ZakSN/m2cpu/software/README

This directory contains software written for the m2cpu. 
The m2cpu assembler is in tools/assembler
