ZakSN/m2cpu/software/hello_world/README

prints "Hello, world!" followed by a blinking cursor, in the middle of the screen
