ZakSN/m2cpu/doc/processor/M2CPU_architecture_diagram.png

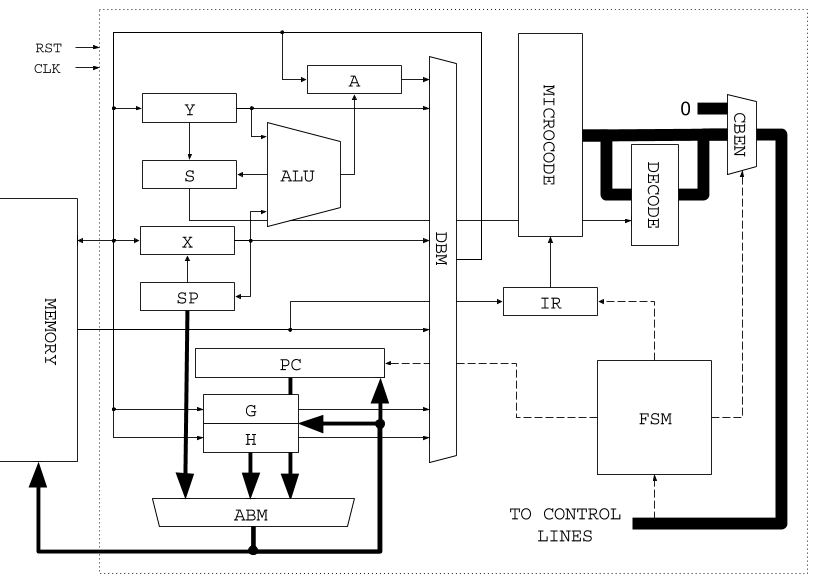
doc/processor/M2CPU_architecture_diagram.png
