ZakSN/m2cpu/doc/processor/M2CPU_FSM.png

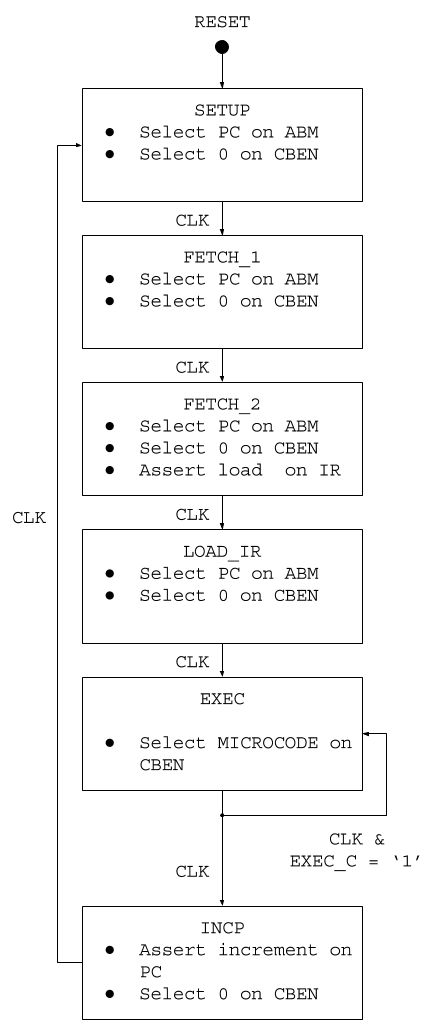
doc/processor/M2CPU_FSM.png
