ZakSN/m2cpu/video/byte_to_text.vhd

library ieee;
use ieee.std_logic_1164.all;
use ieee.numeric_std.all;

entity byte_to_text is port
(
	byte_in : in std_logic_vector(7 downto 0);
	line_out : out std_logic_vector(9 downto 0);
	line_sel : in std_logic_vector(4 downto 0)
);
end entity byte_to_text;

architecture a0 of byte_to_text is
	constant non_printing : integer := 32;
	constant char_set_size : integer := 112;
	signal lo : std_logic_vector(9 downto 0);
	type font_rom_array is array (0 to (char_set_size * 25) - 1) of std_logic_vector(9 downto 0);
	signal font_rom : font_rom_array;
	signal byte_num : integer;
	signal line_num : integer;
	signal c_t_p : integer;
	signal char_to_print : integer;

begin

	byte_num <= to_integer(unsigned(byte_in));
	line_num <= to_integer(unsigned(line_sel));
	-- assuming that all chars we recieve print as either a space or map to a printing char
	-- non printing chars (zero-width) need to be filtered out earlier. 
	-- by the time we get here we have to print something
	-- the next line ensures we print something predictable
	char_to_print <= (byte_num - non_printing) when (byte_num >= non_printing) AND (byte_num < (char_set_size + non_printing - 1)) else 0;
	line_out <= font_rom((char_to_print * 25) + line_num);
	
-- prototype char:
-- top five lines and bottom five lines are blanked for
-- text seperation
-- texh chars have a one pixel buffer on each edge (look at examples below)
--	"0000000000",
--	"0000000000",
--	"0000000000",
--	"0000000000",
--	"0000000000",
--	
--	"0000000000",
--	"0000000000",
--	"0000000000",
--	"0000000000",
--	"0000000000",
--	"0000000000",
--	"0000000000",
--	"0000000000",
--	"0000000000",
--	"0000000000",
--	"0000000000",
--	"0000000000",
--	"0000000000",
--	"0000000000",
--	"0000000000",
--	
--	"0000000000",
--	"0000000000",
--	"0000000000",
--	"0000000000",
--	"0000000000",


-- literal miles of font rom:
-- char are surrounded by "--{X" and "--X}"
-- where X is the particular char

	font_rom <=(
		--{SPACE
		"0000000000",
		"0000000000",
		"0000000000",
		"0000000000",
		"0000000000",
		"0000000000",
		"0000000000",
		"0000000000",
		"0000000000",
		"0000000000",
		"0000000000",
		"0000000000",
		"0000000000",
		"0000000000",
		"0000000000",
		"0000000000",
		"0000000000",
		"0000000000",
		"0000000000",
		"0000000000",
		"0000000000",
		"0000000000",
		"0000000000",
		"0000000000",
		"0000000000",
		--SPACE}
		--{!
		"0000000000",
		"0000000000",
		"0000000000",
		"0000000000",
		"0000000000",
		"0000110000",
		"0000110000",
		"0000110000",
		"0000110000",
		"0000110000",
		"0000110000",
		"0000110000",
		"0000110000",
		"0000110000",
		"0000110000",
		"0000110000",
		"0000000000",
		"0000000000",
		"0000110000",
		"0000110000",
		"0000000000",
		"0000000000",
		"0000000000",
		"0000000000",
		"0000000000",
		--!}
		--{"
		"0000000000",
		"0000000000",
		"0000000000",
		"0000000000",
		"0000000000",
		"0111001110",
		"0111001110",
		"0110001100",
		"0110001100",
		"0000000000",
		"0000000000",
		"0000000000",
		"0000000000",
		"0000000000",
		"0000000000",
		"0000000000",
		"0000000000",
		"0000000000",
		"0000000000",
		"0000000000",
		"0000000000",
		"0000000000",
		"0000000000",
		"0000000000",
		"0000000000",
		--"}
		--{#
		"0000000000",
		"0000000000",
		"0000000000",
		"0000000000",
		"0000000000",
		"0011001100",
		"0011001100",
		"0011001100",
		"0011001100",
		"0111111110",
		"0111111110",
		"0011001100",
		"0011001100",
		"0011001100",
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
		"0101010101",
		"1010101010",
		"0101010101",
		"1010101010",
		"0101010101",
		"1010101010",
		"0101010101",
		"1010101010",
		"0101010101",
		"1010101010",
		"0101010101",
		"1010101010",
		"0101010101",
		"1010101010",
		"0101010101",
		"1010101010",
		"0101010101",
		"1010101010",
		"0101010101",
		"1010101010",
		"0101010101",
		"1010101010",
		--}
		--{ full block (141)
		"1111111111",
		"1111111111",
		"1111111111",
		"1111111111",
		"1111111111",
		"1111111111",
		"1111111111",
		"1111111111",
		"1111111111",
		"1111111111",
		"1111111111",
		"1111111111",
		"1111111111",
		"1111111111",
		"1111111111",
		"1111111111",
		"1111111111",
		"1111111111",
		"1111111111",
		"1111111111",
		"1111111111",
		"1111111111",
		"1111111111",
		"1111111111",
		"1111111111",
		--}
		--{ cursor (142)
		"0000000000",
		"0000000000",
		"0000000000",
		"0000000000",
		"0000000000",
		"1111111111",
		"1111111111",
		"1111111111",
		"1111111111",
		"1111111111",
		"1111111111",
		"1111111111",
		"1111111111",
		"1111111111",
		"1111111111",
		"1111111111",
		"1111111111",
		"1111111111",
		"1111111111",
		"1111111111",
		"0000000000",
		"0000000000",
		"0000000000",
		"0000000000",
		"0000000000",
		--}
		others => "0000000000"
	);

end architecture a0;
