ZakSN/m2cpu/processor/microcode_LUT.vhd

library ieee;
use ieee.std_logic_1164.all;

entity microcode_LUT is port
(
	address : in std_logic_vector(7 downto 0);
	microinstruction : out std_logic_vector(41 downto 0)
);
end entity microcode_LUT;

architecture a0 of microcode_LUT is
begin

	with address select
		microinstruction <= "000000000000000000000000000000000000000000" when "00000000",
									"100000000000000000000000000000000000100001" when "00000001",
									"000000000000000000000000000000000000000001" when "00000010",
									"100000000000000000000000000000000000100010" when "00000011",
									"000000000000000000000000000000000000000010" when "00000100",
									"100000000000000000000000000000000000100011" when "00000101",
									"000000000000000000000000000000000000000011" when "00000110",
									"100000000000000000000000000000000000100100" when "00000111",
									"000000000000000000000000000000000000000100" when "00001000",
									"100000000000000000000000000000000010000000" when "00010001",
									"000000000000000000000000000000000000000000" when "00010010",
									"100000000000000000000000000000000010000010" when "00010011",
									"000000000000000000000000000000000000000010" when "00010100",
									"100000000000000000000000000000000010000011" when "00010101",
									"000000000000000000000000000000000000000011" when "00010110",
									"100000000000000000000000000000000010000100" when "00010111",
									"000000000000000000000000000000000000000100" when "00011000",
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
									"000001000000000000000000000000000000000000" when "01011110",
									"000000001000000000000000000000000000000000" when "01101110",
									"000000010000000000000000000000000000000000" when "01111110",
									(0 => '0', others => '0') when others;
end architecture a0;
