ZakSN/m2cpu/video/vertical_signal.vhd

library ieee;
use ieee.std_logic_1164.all;
use ieee.numeric_std.all;

entity vertical_signal is
generic
(
	-- constants for vertical resolution
	-- units of lines
	front_porch : integer;
	sync_pulse : integer;
	back_porch : integer;
	active_video : integer;
	-- polarity of sync pulse
	sync_pulse_pol : std_logic;
	-- constant for line length
	-- unit of pixels
	pixel_per_line : integer
); 
port
(
	vsync_out : out std_logic; -- vertical sync
	len_out : out std_logic; -- line enable
	clk : in std_logic; -- pixel clock in
	rs : in std_logic -- async reset
);
end entity vertical_signal;

architecture a0 of vertical_signal is

	constant line_number : integer := (front_porch + sync_pulse + back_porch + active_video) * pixel_per_line;
	constant fpsp : integer := (front_porch + sync_pulse) * pixel_per_line;
	constant fpspbp : integer := (front_porch + sync_pulse + back_porch) * pixel_per_line;
	signal line_counter : integer := 0;
	signal len : std_logic;
	signal vsync : std_logic;

begin
	
	vsync_out <= vsync;
	len_out <= len;
	
	vs : process (clk, rs)
	begin
		if (rs = '1') then
			len <= '0';
			vsync <= '0';
			line_counter <= 0;
		elsif (rising_edge(clk)) then
			
			if (line_counter = line_number - 1) then
				line_counter <= 0;
			else
				line_counter <= line_counter + 1;
			end if;
			
			if (line_counter < (front_porch * pixel_per_line)) then
				len <= '0';
				vsync <= NOT(sync_pulse_pol);
			elsif ((line_counter >= (front_porch * pixel_per_line)) AND (line_counter < fpsp)) then
				len <= '0';
				vsync <= sync_pulse_pol;
			elsif ((line_counter >= fpsp) AND (line_counter < fpspbp)) then
				len <= '0';
				vsync <= NOT(sync_pulse_pol);
			else
				len <= '1';
				vsync <= NOT(sync_pulse_pol); 
			end if;
			
		else 
			len <= len;
			vsync <= vsync;
			line_counter <= line_counter;
		end if;
	end process vs;

end architecture a0;
