ZakSN/m2cpu/tools/assembler/cmd_line.h

#include <string>

#ifndef _CMD_LINE_H
#define _CMD_LINE_H
struct cmd{
	bool verbose;
	std::string infile;
	std::string outfile;
	int base_addr;
	bool give_up;
};

cmd parse_cmd (int argc, char** argv);
void usage_error();
#endif
