ZakSN/m2cpu/(commit log)

2017-10-12 started the ALU. does not work yet, *at all*
    [arithmetic_logic_unit.vhd, m2cpu_top.vhd]
2017-10-15 stack pointer: reloadable, increments, decrements
    [m2cpu_ISA.ods]
2017-10-22 wired up the non-control-logic
2017-10-22 surprisingly few fixes to get it to synthesize...
    [central_processing_unit.vhd]
2017-10-27 complete documentation of the instruction set
    [m2cpu_ISA.ods]
2017-10-29 didn't get instruction_register source...
    [finite_state_machine.vhd, instruction_register.vhd, status_register.vhd]
2017-11-01 additional documentation/corrections
    [m2cpu_ISA.ods]
2017-11-02 wired up the entire process, will try to synthesize tomorrow... that'll be fun
2017-11-02 fixes to get this mess to synthesize
    [central_processing_unit.vhd, finite_state_machine.vhd, instruction_register.vhd, m2cpu_top.vhd, status_register.vhd]
2017-11-02 changed PC to have more easily modifiable reset vector
    [program_counter.vhd]
2017-11-03 hooked up debug bus, set reset vector to correct value
    [central_processing_unit.vhd, m2cpu_top.vhd, program_counter.vhd]
2017-11-05 added logic to connect the computer to the dev-board's IO
2017-11-08 made some serious errors in how everything was timed. this commit is the end of this branch for now. I'm moving to a topic to try and redo some things
    [central_processing_unit.vhd, clock_divider.vhd, finite_state_machine.vhd, m2cpu_top.vhd]
2017-11-10 removing unnecessary files/stuff that needs to be rewritten from scratch
    [m2cpu_ISA.ods]
2017-11-11 rewired the CPU, and rethought the ISA a bit. changing from microcode rom to microcode lut, not yet implemented. docs out of date
    [m2cpu_ISA.ods]
2017-11-11 cleaned up the docs a bit, still not quite accurate
    [m2cpu_ISA.ods]
2017-11-12 update .gitignore so I stop sucking up swap files :-/
    [m2cpu_ISA.ods]
2017-11-12 syntax fixes to get this to synthesize
    [central_processing_unit.vhd, m2cpu_top.vhd, microcode_LUT.vhd]
2017-11-16 fixed pop this time, last time was fixing push, I screwed up the commit message
    [m2cpu_ISA.ods]
2017-11-18 beginnings of a simple assembler
2017-11-18 assembler removes whitespace and comments. updated gitignore
2017-11-19 add instruction substitution to assembler
2017-11-19 undid addressing. added constant replacement
    [main.cpp]
2017-11-19 the core of the assembler seems to work
2017-11-19 assembler more or less works, doesn't generate .hex files yet
    [main.cpp]
2017-11-19 gitignore was broken, and missed some parts of the assembler
    [cmd_line.cpp, cmd_line.h, test.asm, test2.asm]
2017-11-21 refactor assembler to break the parser bit's out into their own files
2017-11-22 finished (but untested) assembler
2017-11-26 changing LDPC GH to JMP, and modifying hardware accordingly
    [m2cpu_ISA.ods]
2017-11-26 successfully changed LDPC GH to JMP
    [m2cpu_ISA.ods]
2017-11-28 added simple implementation of the euclidean algorithm. fixed error in PPq (pop) instructions.
    [central_processing_unit.vhd, microcode_LUT.vhd]
2017-12-07 a couple tweaks to get the timings exactly right
2017-12-13 working on hello world, cursor blink is wrong, but w/e
    [byte_to_text.vhd]
2017-12-15 reworked directory structure to better reflect the project
    [address_shift_register.vhd, arithmetic_logic_unit.vhd, branch_decoder.vhd, byte_display.vhd, central_processing_unit.vhd, clock_divider.vhd, debouncer.vhd, finite_state_machine.vhd]
2017-12-15 cleaned up instruction code spreadsheet
    [m2cpu_ISA.ods]
2017-12-16 updated colour scheme in ISA spreadsheet
    [m2cpu_ISA.ods]
